LithosphereRocketry/Nandy/README.md

# NANDy
Nandy (capitalization variable) is an 8-bit RISC computer architecture built for implementation using simple 74xx-series discrete NAND gates. It was inspired by the theorem shown in most digital logic classes that any piece of combinational logic may be recreated as a network of NAND gates.
