LithosphereRocketry/Nandy/Toolchain/io-layout.md

## Default I/O space layout for emulator

| Address range | Device        | Interrupt number |
| ============= | ============= | ================ |
| 0x00          | Serial port   | 0                |
| 0x10 - 0x18   | CompactFlash  | 1                |
