LithosphereRocketry/Nandy/Design/DesignPrinciples.md

# NANDy Design Principles

## Overview of Design Principles
The NANDy architecture was built around several design goals:
1. Simplicity. I have not a lot of budget for this project and even less time to spend soldering hundreds of components. Therefore, the primary goal is to make this CPU as simple as possible.
2. Usability. While I could make a [Subleq](https://en.wikipedia.org/wiki/One-instruction_set_computer#Subtract_and_branch_if_less_than_or_equal_to_zero "Wikipedia: One-instruction set computer: Subleq") or [Brainfuck](https://en.wikipedia.org/wiki/Brainfuck "Wikipedia: Brainfuck") machine with potentially less components, these architectures are simplistic to the point of being painful to use for even basic tasks. Therefore, the ISA of this processor must be capable enough that someone might actually want to use it.
3. Performance. This is the least important design tenet to me; this is primarily a demonstration and not really designed to accomplish any particular task. However, it would be pretty neat if it could run at a respectable clockspeed.

## Architecture
NANDy uses a simple von Neumann accumulator architecture, with one accumulator register, two data and two address registers, and one stack pointer register. All mathematical operations place their result in the accumulator with the exception of stack-pointer increment instructions. Data memory and program memory use a shared 16-bit memory bus; all addresses with a most significant bit of 1 are read/write, while all addressses with a most significant bit of 0 are read-only.
   
The architecture is implemented mostly as a single cycle with single-byte instructions, with all register reads continuous and all register writes on the same clock edge. Jumps, memory accesses, and most immediate operations require two cycles; jumps and immediate options also occupy two bytes of program memory, while memory accesses occupy only one.

A core design principle of this architecture is to minimize stored state as much as possible. Stateless logic is easier to automatically test, less costly to build, and less sensitive to timing constraints, and on an architecture of this degree of simplicity the gains in performance from multicycle or pipelined execution are minimial. As designed, the architecture has 108 bits of state not including memory:
* One 16-bit program counter,
* One 8-bit instruction register,
* Four 8-bit registers (ACC, SP, DX, DY),
* Three 16-bit registers (P, Q, IA),
* Four bits of logical state (cycle, carry, interrupt enable, interrupt active)

### Instruction types
