LithosphereRocketry/Nandy/Design/datapath.png

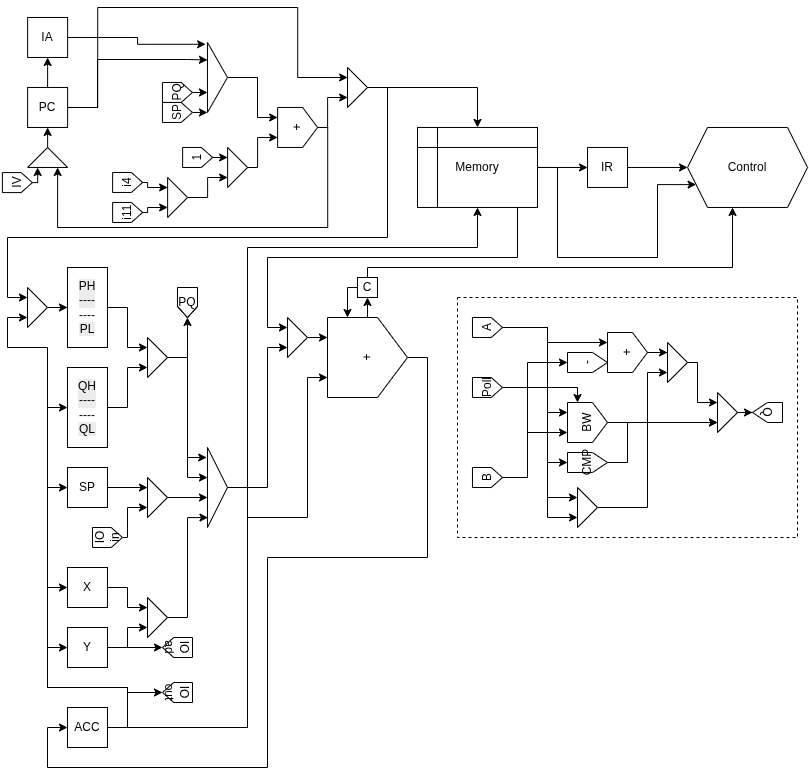
Design/datapath.png
