LithosphereRocketry/Nandy/Design/intel_bus_timing.png

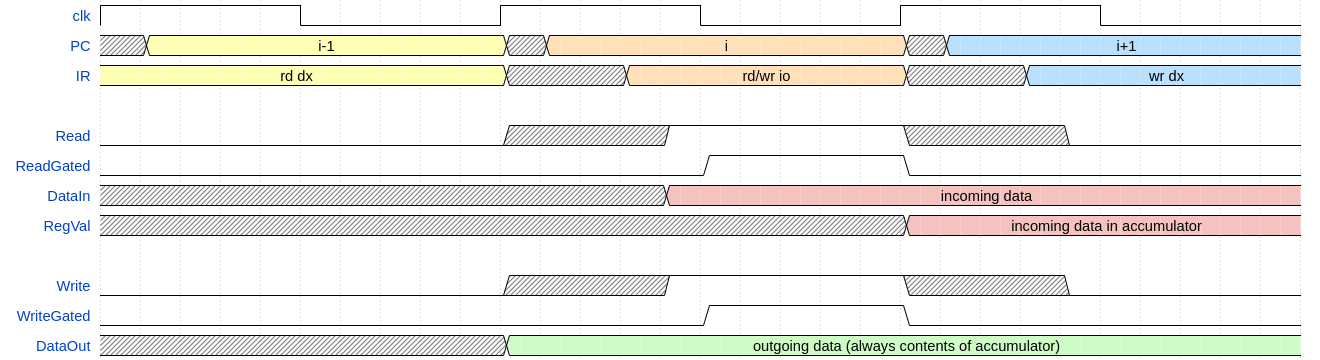
Design/intel_bus_timing.png
