LithosphereRocketry/Nandy/(list of files, drawings)

Other design files:
Simulation/nandy-peripherals.circ
Simulation/nandy.circ
