LithosphereRocketry/Nandy/Implementation/Nandy/mux9/mux9.kicad_pcb

## KiCad design Cricuit/data_aquisition.kicad_sch

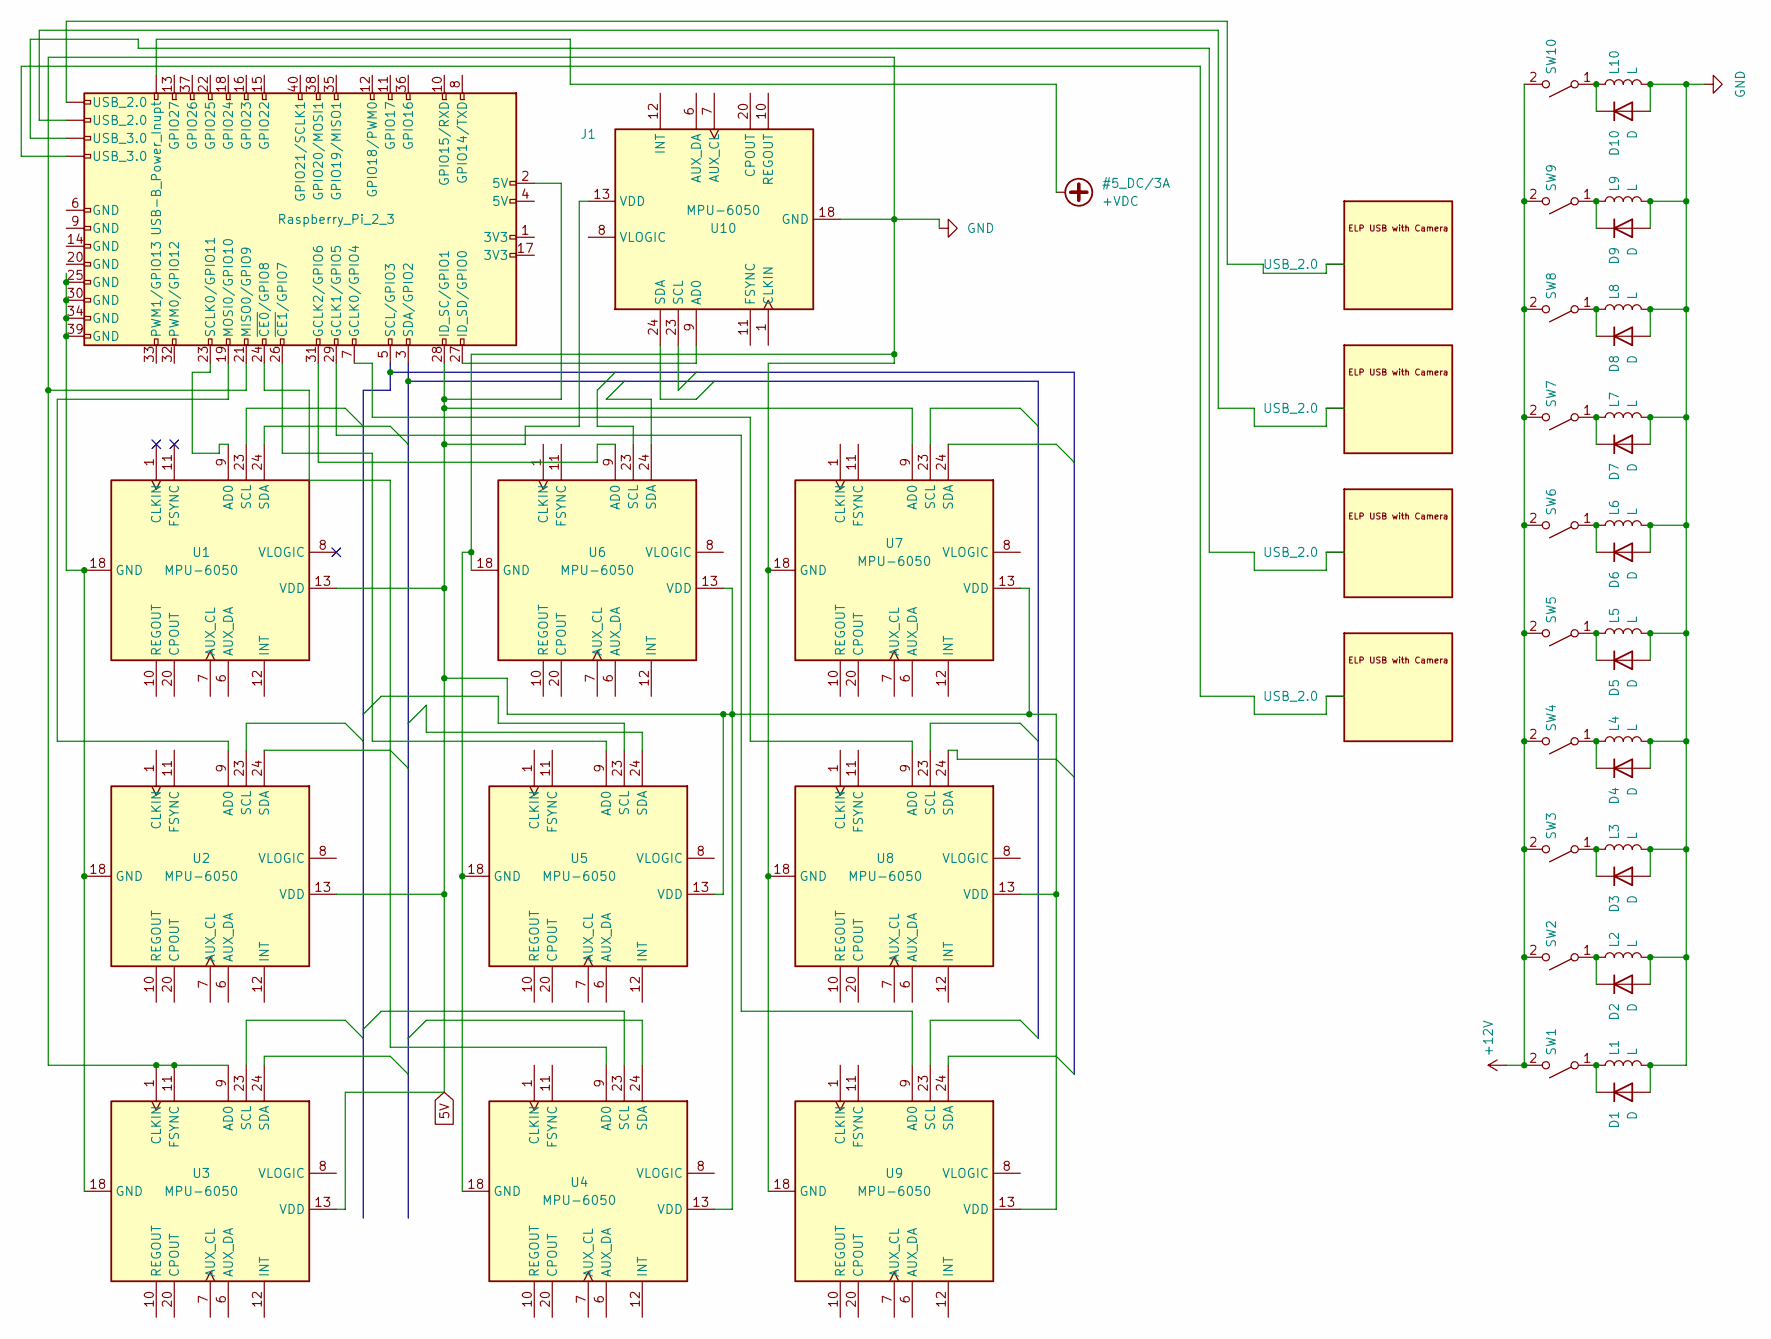
[picture p3: schematic data_aquisition.kicad_sch]

Parts:
D1, D2, D3, D4, D5, D6, D7, D8, D9, D10: D
J1: Raspberry_Pi_2_3
L1, L2, L3, L4, L5, L6, L7, L8, L9, L10: L
SW1, SW2, SW3, SW4, SW5, SW6, SW7, SW8, SW9, SW10: SW_SPST
U1, U2, U3, U4, U5, U6, U7, U8, U9, U10: MPU-6050; InvenSense_QFN-24_4x4mm_P0.5mm
U11, U12, U13, U14: Flir_LEPTON

Connections:
5V: J1.2 (5V), J1.28 (ID_SC/GPIO1), U1.13 (VDD), U2.13 (VDD), U3.13 (VDD), U4.13 (VDD), U5.13 (VDD), U6.13 (VDD), U7.9 (AD0), U7.13 (VDD), U8.13 (VDD), U8.24 (SDA), U9.13 (VDD), U9.24 (SDA), U10.13 (VDD)
+12V: SW1.2 (B), SW2.2 (B), SW3.2 (B), SW4.2 (B), SW5.2 (B), SW6.2 (B), SW7.2 (B), SW8.2 (B), SW9.2 (B), SW10.2 (B)
+VDC: J1. (USB-B_Power_Inupt)
GND: D1.2 (A), D2.2 (A), D3.2 (A), D4.2 (A), D5.2 (A), D6.2 (A), D7.2 (A), D8.2 (A), D9.2 (A), D10.2 (A), J1.21 (MISO0/GPIO9), L1.2, L2.2, L3.2, L4.2, L5.2, L6.2, L7.2, L8.2, L9.2, L10.2, U3.1 (CLKIN), U3.9 (AD0), U3.11 (FSYNC), U4.18 (GND), U5.18 (GND), U6.18 (GND), U7.18 (GND), U8.18 (GND), U9.18 (GND), U10.18 (GND)
unnamed: D1.1 (K), L1.1, SW1.1 (A)
unnamed: D2.1 (K), L2.1, SW2.1 (A)
unnamed: D3.1 (K), L3.1, SW3.1 (A)
unnamed: D4.1 (K), L4.1, SW4.1 (A)
unnamed: D5.1 (K), L5.1, SW5.1 (A)
unnamed: D6.1 (K), L6.1, SW6.1 (A)
unnamed: D7.1 (K), L7.1, SW7.1 (A)
unnamed: D8.1 (K), L8.1, SW8.1 (A)
unnamed: D9.1 (K), L9.1, SW9.1 (A)
unnamed: D10.1 (K), L10.1, SW10.1 (A)
unnamed: J1.7 (GCLK0/GPIO4), U8.9 (AD0)
unnamed: J1.19 (MOSI0/GPIO10), U2.9 (AD0)
unnamed: J1.23 (SCLK0/GPIO11), U1.9 (AD0)
unnamed: J1.24 (~CE0/GPIO8), U2.24 (SDA), U4.9 (AD0)
unnamed: J1.25 (GND), J1.30 (GND), J1.34 (GND), J1.39 (GND), U1.18 (GND), U2.18 (GND), U3.18 (GND)
unnamed: J1.26 (~CE1/GPIO7), U5.9 (AD0)
unnamed: J1.27 (ID_SD/GPIO0), U10.9 (AD0)
unnamed: J1.29 (GCLK1/GPIO5), U9.9 (AD0)
unnamed: J1.31 (GCLK2/GPIO6), U6.9 (AD0)
unnamed: J1. (USB-B_Power_Inupt), U11., U12., U13., U14.
