LithosphereRocketry/Nandy/Implementation/Nandy/mux9/mux9.kicad_pcb

## KiCad design KiCad/cmd_sat.kicad_sch

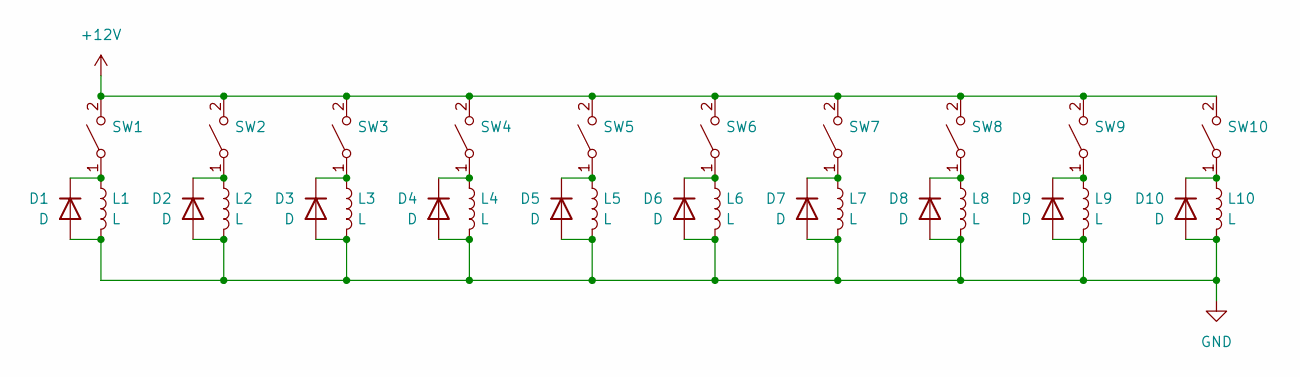
[picture p4: schematic cmd_sat.kicad_sch]

Parts:
D1, D2, D3, D4, D5, D6, D7, D8, D9, D10: D
L1, L2, L3, L4, L5, L6, L7, L8, L9, L10: L
SW1, SW2, SW3, SW4, SW5, SW6, SW7, SW8, SW9, SW10: SW_SPST

Connections:
+12V: SW1.2 (B), SW2.2 (B), SW3.2 (B), SW4.2 (B), SW5.2 (B), SW6.2 (B), SW7.2 (B), SW8.2 (B), SW9.2 (B), SW10.2 (B)
GND: D1.2 (A), D2.2 (A), D3.2 (A), D4.2 (A), D5.2 (A), D6.2 (A), D7.2 (A), D8.2 (A), D9.2 (A), D10.2 (A), L1.2, L2.2, L3.2, L4.2, L5.2, L6.2, L7.2, L8.2, L9.2, L10.2
unnamed: D1.1 (K), L1.1, SW1.1 (A)
unnamed: D2.1 (K), L2.1, SW2.1 (A)
unnamed: D3.1 (K), L3.1, SW3.1 (A)
unnamed: D4.1 (K), L4.1, SW4.1 (A)
unnamed: D5.1 (K), L5.1, SW5.1 (A)
unnamed: D6.1 (K), L6.1, SW6.1 (A)
unnamed: D7.1 (K), L7.1, SW7.1 (A)
unnamed: D8.1 (K), L8.1, SW8.1 (A)
unnamed: D9.1 (K), L9.1, SW9.1 (A)
unnamed: D10.1 (K), L10.1, SW10.1 (A)
