LithosphereRocketry/Nandy/Simulation/src/intcontrol.v

`timescale 1ns/1ps

module intcontrol(
        input [15:0] pcin,
        input nie,
        input nid,
        input int,
        input nclr,
        input nis,
        input nic,
        input ncycle,
        input clk,
        input rst,

        output [15:0] pcout,
        output ienabled,
        output istatus
    );

    // Positive-edge pulse generation
    // All latches here can use ~2C as an enable input, so we can avoid also
    // piping that into the interrupt logic AND gate to save a gate or two
    wire ntick, tick;
    edgegate #(1) eg(
        .clk(clk),
        .en(ncycle),
        .out(ntick)
    );
    invert invtick(.a(ntick), .q(tick));

    wire nready, nistatus;
    // TODO: is ncycle redundant on the enable/disable inputs?
    nand10 gready(
        .a(ienabled),
        .b(nistatus),
        .c(int & ncycle),
        .q(nready)
    );

    // Manual set/reset
    // Because of negative logic this is basically an or gate
    wire intsrset;
    nand00 gmanualset(
        .a(nready),
        .b(nis),
        .q(intsrset)
    );

    wire intsrclr;
    nand00 gmanualclr(
        .a(nclr),
        .b(nic),
        .q(intsrclr)
    );

    srlatch intsr(
        .s(intsrset),
        .r(intsrclr),
        .en(tick),
        .nclr(rst),
        .q(istatus),
        .nq(nistatus)
    );

    // Technically it's probably possible to build the interrupt-jump mux with
    // just ands and ors to save a few gates, but using a mux means it's easier
    // to wrap your brain around and the interrupt vector can be moved later
    mux #(16) mpc(
        .a(16'h7F00),
        .b(pcin),
        .s(nready),
        .q(pcout)
    );

    // Interrupt enable/disable
    wire ie, id;
    invert invens(.a(nie), .q(ie));
    invert invenc(.a(nid), .q(id));
    srlatch ensr(
        .s(ie),
        .r(id),
        .en(tick),
        .nclr(rst),
        .q(ienabled)
    );

endmodule
