LithosphereRocketry/Nandy/(commit log)

2022-12-07 Basic project structure for assembler/emulator
2022-12-11 Setting up the framework of the assembler
2022-12-16 Switched polarity of comparison
2022-12-17 Minor fix to bitwise spec, also finished ISA definitions
    [bitwiseblock.v]
2023-01-06 Built some ALU, there are some problems with the comparison block ;
    [alu.v, bitwiseblock.v, orgate.v]
2023-02-06 Move 16bit datapath to current
2023-05-01 Many things, parsing stuff for assembler, test ABCs program, test circuits for new register design
2023-05-24 Start of inserting instructions inline
2023-08-07 Set up framework for Icarus Verilog
2023-08-09 Add description of assembler symbols
2023-08-09 fixed another test; still dont really like it
    [tb_nand10.v]
2023-08-20 Gave the racket assembler a basic CLI
2023-10-23 Add `goto` macro to assembler
2023-10-29 Added interrupts to datapath drawing
2023-11-02 Switching to Logisim for high-level design
    [nandy.circ]
2023-11-02 Switched jumps to only conditional
2023-11-06 Added Logisim simulation
    [nandy.circ]
2023-11-18 Added some test circuits to logisim
    [nandy.circ]
2023-11-18 Updated assembler to new ISA- needs testing
2023-11-18 Renamed debug interrupt for clarity
2023-11-18 Updated logisim ALU; inverted zero/nzero opcodes
    [nandy.circ]
2023-11-19 Added jri and @loc to assembler
2023-11-19 Updated interrupts in circuit
    [nandy.circ]
2023-11-19 Fixed some errors in assembling gotos
2023-11-19 Fixed interrupt handling in logisim model
    [nandy.circ]
2023-11-21 Fixed typo in xornand
    [tb_xornand.v]
2023-11-22 Switched a few ops to make bitwise block smaller
2023-11-23 Finished rest of ALU
    [nandy.circ]
2023-11-23 Moved away obsolete assembler files
2023-11-23 Moved away obsolete assembler files, pt2
2023-11-27 Basic interrupt handling without logic
2023-11-27 Added basic interrupt support to emulator
2023-11-27 Turns out the interrupt issue was actually just bad code
2023-11-28 Updated logisim with jcz
    [nandy.circ]
2023-12-06 Manual interrupts
2023-12-06 Simulation and guide for manual IR
    [nandy.circ]
2023-12-06 Added signum instruction
    [nandy.circ]
2023-12-06 Gitignore template for KiCad
2023-12-18 Register design; struggling with kicad automation
    [Nandy.kicad_pcb, Nandy.kicad_sch, inport.kicad_sch, outport.kicad_sch, register-rounded.kicad_pcb, register.kicad_pcb, register.kicad_sch]
2023-12-18 DRC verification working automatically
    [register.kicad_pcb]
2023-12-19 Reworked Makefile with kikit
    [register.kicad_pcb]
2023-12-26 Oops big commit; added waveform outputs, RAM simulation, and a few other parts
    [nandy.circ]
2023-12-26 Logisim sketch of ram bus control
    [nandy.circ]
2023-12-26 Long overdue edgedet testbench
    [nandy.circ]
2023-12-28 Simplified & fixed some control logic
    [nandy.circ]
2023-12-29 Inverted edgegate signal bc it saves one gate in memory
    [edgegate.v, register.v, tb_edgegate.v, tb_register.v]
2023-12-29 More of the memory system
    [nandy.circ]
2023-12-29 Cleaned up some stuff in circ
    [nandy.circ]
2023-12-29 Inverted the polarity of signals to save a few gates
    [control.v, tb_control.v]
2023-12-29 Added negative outputs to latches + added SR latch
    [nandy.circ]
2023-12-30 Experimental interrupt control; inverted a signal in control to save a gate again
    [nandy.circ]
2023-12-30 Started on the terror that is regfile, inverted another few signals for efficiency
    [control.v, core.v, regfile.v, tb_control.v]
2023-12-30 acc, sp, dx in regfile
    [nandy.circ]
2023-12-31 Passback logic, untested
    [nandy.circ]
2023-12-31 Saved a mux in register file at the cost of making it even more complicated
    [nandy.circ]
2023-12-31 Switched some random logic to more descriptive layout
2023-12-31 Made interrupt non-repeat logic more watertight
    [nandy.circ]
2024-01-21 Start of 9-bit mux;
    [inport.kicad_sch, mux9.kicad_pcb, mux9.kicad_sch, outport.kicad_sch]
2024-01-21 Added latches for more consistent IOread/IOwrite
    [nandy.circ]
2024-02-03 Working on moving assembler to C
2024-02-22 datastructures for new assembler
2024-02-23 Powers of 2 WIP
2024-02-23 Progress on poweroftwo, still sometimes crashes
2024-02-23 power-of-two test works :)
2024-03-01 Basic cloc support for NANDy assembly
2024-03-05 Updated register to kicad7
    [inport.kicad_sch, outport.kicad_sch, register.kicad_sch]
2024-03-19 RDA macro in assembler
2024-03-19 Basics of label recognition in the C assembler
2024-03-21 Checking for multiple stacked assembly instructions
2024-03-28 Got rid of pointless whole CPU in assembler struct
2024-03-30 Bare minimum shunting yard implementation, argument resolution in assembler
2024-04-12 Echo command for assembler
2024-04-13 Assembly assertions
2024-04-21 Comparison tools for assembler output
2024-04-21 New assembler works WOOOOOO
2024-04-23 Documentation for new assembler
2024-04-23 Officially deprecated Racket assembler
2024-04-23 Removed old comparison stuff between assemblers
2024-04-26 Logisim model for interfaces
    [nandy-peripherals.circ]
2024-04-30 Fixed a major bug involving absolute reads in interrupts in emu
2024-05-03 Minor nitpick in interrupt handling
2024-05-10 Optimization of gate count :)
    [nandy.circ]
2024-05-12 Circ and documentation, wip
    [nandy.circ]
2024-05-22 4-input mux, but I don't think it's calculating latency right
    [nandy.circ]
2024-05-27 Updates to documentation and logisim
    [nandy.circ]
2024-05-27 Restored old version of .circ file
    [nandy.circ]
2024-05-27 Switched regfile in verilog to 4-input version
    [nandy.circ]
2024-05-27 Some labels in circ
    [nandy.circ]
2024-05-27 Fixed inverted IRX/Y write logic
    [regfile.v]
2024-05-31 Fixed issues with the Verilog interrupt implementation
    [nandy.circ]
2024-09-28 Datapath updates to remove isp
    [nandy.circ]
2025-11-22 A bunch of assorted WIP on IO rework
    [nandy.circ]
2025-11-23 Removed unicode dash in sample text
2025-11-29 Separate interrupt stack in emu, some better documentation, some more work on IO
2025-12-20 Fixed interrupt handling and add PC-relative and conditional call instructions
    [nandy_definitions.h]
2025-12-21 WIP CF test, some work on CF support in emulation, more reasonable assembler output text
2025-12-25 Temporarily stash old verilog
    [nandy.circ]
2025-12-25 Fixed a few assembler bugs and improved ergonomics for assembler and emulator
2026-05-24 Fix a type mismatch in interrupt handler
2026-05-28 Fixed a bunch of dumb syntax errors and started work on revamping tests
    [addr_calc.v, alu.v, bitwise.v, compare.v, control.v, core.v, debug.v, memory.v]
2026-05-28 First handful of instructions working correctly!
    [alu.v, control.v, core.v, tb_system.v]
2026-05-28 Print string program running in Verilog
2026-06-28 FPGA design in progress, overall design might need some rework tho
    [addr_calc.v, alu.v, control.v, core.v, memory.v, split_reg.v, tb_system.v, toplevel.v]
